RobertClausen/Quick-Ruler/README.md

7d75a078-2ea6-45a3-ad7b-7f2f3f713c77

# Quick Ruler
By using the IR sensor, we can measure the distance between the sensor and the object with the range of 10cm to 80cm. That's more than two ruler worth of measurable distance!

This project is made thanks to the my special topic class where to try our best to calibrate a cheap sensor the achieve a fine measurement. In this case, we chosen the IR distance sensor from Sharp that is widely used as a counterpart from the ultrasonic sensor.

6ab4340e-c0da-4cd3-a43c-5337176d39e8

# BOM
- STM32 Blue pill
- Seeed Studio ESP32-C3
- 128x32 OLED display
- Sharp GP2Y0A21YKOF IR distance sensor
- M1x8 screws

This project requires soldiering, an open room with good ventilation is advised.

# Code

| Path | What it is |
|---|---|
| `firmware/stm32-bluepill/` | Blue Pill: samples the Sharp sensor, streams frames over UART |
| `firmware/esp32-xiao-c3/` | XIAO ESP32-C3: OLED readout + BLE bridge to the PC |
| `pc/` | Calibration bench — live graphs, ruler-referenced capture, CSV export |
| `tools/` | Bring-up helpers used to find the wiring (see `docs/HARDWARE.md`) |
| `docs/HARDWARE.md` | Verified pinout, the link protocol, and the traps worth knowing |

## Wiring

| From | To |
|---|---|
| Sharp sensor output | STM32 **PA0** (ADC1_IN0) |
| STM32 **PA9** (USART1_TX) | ESP32 **GPIO20** (D7) |
| STM32 **PA10** (USART1_RX) | ESP32 **GPIO21** (D6) |
| OLED SDA / SCL | ESP32 **GPIO6** / **GPIO7**, address `0x3C` |

The Sharp sensor needs 5 V; the STM32 and ESP32 are 3.3 V parts, but the
sensor's analog output stays inside the ADC range so no divider is required.

## Build and flash

Both boards are [PlatformIO](https://platformio.org/) projects — it fetches the
ARM and Xtensa toolchains itself, so there is nothing to install by hand.

```bash
cd firmware/stm32-bluepill && pio run -t upload      # over SWD via ST-LINK
```

```bash
cd firmware/esp32-xiao-c3 && pio run -t upload --upload-port /dev/ttyACM0
```

## Calibration bench

```bash
pip install -r pc/requirements.txt
python3 pc/calib_server.py     # then open http://127.0.0.1:8765
```

Scan for the sensor and click it to connect.

### Calibration sweep — the whole range in one CSV

Set a start, an end, a step and a sample count (defaults: 100 → 800 mm in 5 mm
steps, 100 samples each — 141 steps), then **Start sweep…**. The bench walks you
through it one position at a time:

1. it shows the distance to move to, big
2. you position the sensor against the ruler
3. press **space** (or click Capture) and hold still while it takes the samples
4. it advances to the next distance automatically

**Redo last** re-takes the previous step if you fumbled one, **Skip** passes over
a distance you cannot reach, and **Finish & save** ends early keeping everything
captured so far. Both files are rewritten after every step, so a long session
survives a crash.

The whole sweep lands in **one** file:

| File | Contents |
|---|---|
| `sweep_<start>-<end>mm_<timestamp>.csv` | every sample of every step, tagged with `step` and `reference_mm` |
| `sweep_..._steps.csv` | one row per distance: mean/σ/min/max voltage — the fit-ready table |

Feed `reference_mm` against `volts_mean` from the steps file into Excel to fit
the curve. The bench also fits it live as you go, in log-log space, and shows

```
V = K · d_cm^-E        →        d_mm = 10 · (K / V)^(1/E)
```

with its R², so you can see the curve forming and catch a bad run before you
have spent an hour on it. The fitted curve is drawn over the points in green.

### Single spot check

**Record sample…** still captures one distance to its own
`run_<distance>mm_<timestamp>.csv`, appended to `calibration_summary.csv` —
handy for verifying the rig before committing to a full sweep.

Captured data is gitignored: it belongs to your bench, not the repo.

The STM32 sends **raw ADC counts, never millimetres**: the distance curve lives
on the ESP32/PC side, so recalibrating never means reflashing the sensor board.
