RobertClausen/Quick-Ruler/(list of files, cad)

Other CAD files:
CAD/MainAssembly_v1-1-1.STEP
