RobertClausen/Quick-Ruler/(commit log)

2026-09-15 Add MainAssembly CAD model, tracked via Git LFS
    Configure Git LFS for common CAD formats (STEP, IGES, STL,
    SolidWorks, Fusion 360, Inventor, Parasolid, DWG/DXF) so large
    binary revisions do not bloat repository history.
    [MainAssembly_v1-1-1.STEP]
2026-09-15 Add firmware, calibration bench and hardware notes
    The repository held only the CAD model and README, so this brings in the
    software side of Quick Ruler.
    firmware/stm32-bluepill
    Samples the Sharp GP2Y0A21YK0F on PA0 with 16x oversampling and emits one
    checksummed frame per sample on USART1:
    $IR,<seq>,<adc>,<rate_hz>*<xor checksum>
    Raw ADC counts are sent rather than millimetres so that recalibrating never
    means reflashing the sensor board. Accepts RATE and PING on PA10.
    firmware/esp32-xiao-c3
    Validates each frame, converts counts to volts and millimetres, drives the
    128x32 SSD1306, and relays every sample to a PC over BLE (Nordic UART
    Service). Shows NO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
2026-09-15 Capture a whole calibration sweep into one CSV
    Calibrating meant one CSV per distance, which is awkward when the goal is to fit
    a curve across the full 100-800 mm range. A sweep is now a single session.
    Set start, end, step and samples-per-step; the bench then walks the range one
    position at a time, showing the distance to move to, taking the samples on a
    keypress, and advancing. Space captures, so the operator can keep one hand on
    the ruler. Redo re-takes the previous step, skip passes over an unreachable
    distance, and finishing early keeps everything captured so far.
    Output is two files per sweep:
    sweep_<start>-<end>mm_<stamp>.csv every sample, tagged with its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
2026-09-15 Turn the OLED divider into a 100-800 mm distance bar
    The horizontal rule between the two text rows was purely decorative. It now
    carries the reading: a framed bar spanning the sensor's usable range that fills
    left to right as the target moves away, with tick marks every 100 mm.
    Fill is linear in distance across 126 px, so 450 mm sits exactly halfway. Out of
    range the digits already read ---, and a 4 px stub pegs to whichever end was
    exceeded so "too close" and "too far" stay distinguishable rather than both
    rendering as an empty bar.
    Vertical space drove the geometry: the distance digits have no descenders and
    stop at row 16, the bottom row's 6x10 text starts at row 24, leaving rows 17..22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
    [main.cpp]
